Yonvay/Servomechanisms_projects/Academic Project/Trayectoria/analysisDH.jpg

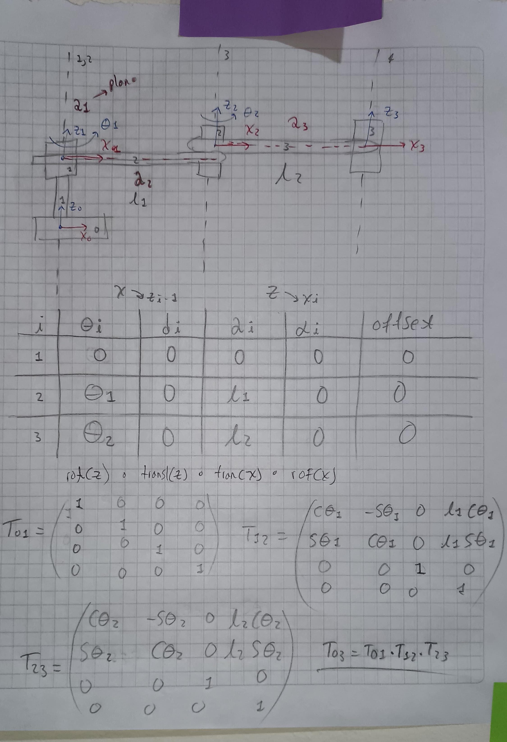
Academic Project/Trayectoria/analysisDH.jpg
