Yonvay/Servomechanisms_projects/README.md

# Servomechanisms_projects
Academic and industrial project, the first is a robotic arm capable of drawing a clover with more than 2 leaves. The second is a box assembler, with 3 servomotors.
