Yonvay/Servomechanisms_projects/Academic Project/Proyecto academico, R. David, M. Brian & V. Yovany.pdf

Informe Tecnico de Ingenier ´ | ía: Mecanismo 2R de Movimiento Controlado

Yovany Esneider Vargas Gutierrez Ingeniería Mecatronica ´
Universidad Nacional de Colombia Bogota, Colombia ´
yvargasgu@unal.edu.co

David Andres Ricaurte de Lima ´ Ingeniería Mecatronica ´
Universidad Nacional de Colombia Bogota, Colombia ´
dricaurte@unal.edu.co
Brian Enrique Munoz Garc ˜ | ía
Ingeniería Mecatronica ´
Universidad Nacional de Colombia Bogota, Colombia ´
bmunozg@unal.edu.co

Abstract—This academic project involves the design, implementation, and validation of a 2R mechanism with 2 degrees of freedom (DOF) that can automatically follow a predefined ”stylized clover” trajectory. The project emphasizes collaborative learning through Problem-Based Learning (PBL) and includes modeling, simulations, and physical experiments. The mechanism operates in a vertical plane with two motorized rotational joints, with trajectory tracking and real-time visualization.
Index Terms—2R Mechanism, Servomechanism, Problem-Based Learning (PBL), Degrees of Freedom (DOF), Controlled Trajectory, Collaborative Work, Mechatronics Engineering.
I. INTRODUCCION´
A. Descripcion del Problema ´
El problema que se busca resolver en este proyecto es el desarrollo y validacion de un mecanismo 2R con 2 grados de ´ libertad (DOF) capaz de seguir una trayectoria predefinida en un plano vertical. Este mecanismo es esencial en aplicaciones donde se requiere un control preciso del movimiento, como en robots o sistemas automatizados. La dificultad radica en garantizar que el mecanismo siga la trayectoria con precision, ´ manteniendo una velocidad constante y permitiendo ajustes de escala y rotacion, lo cual es fundamental para aplicaciones ´ industriales y de investigacion. ´
B. Objetivos
1) Objetivo General:
a) Concebir, disenar, implementar y validar un ˜ mecanismo 2R controlado que siga una trayectoria definida con precision. ´
2) Objetivos Específicos:
a) Realizar el modelado matematico y simulaciones ´ del mecanismo 2R.
b) Implementar físicamente el mecanismo y sus componentes motorizados.
c) Desarrollar un sistema de control que permita la automatizacion del seguimiento de la trayectoria. ´
d) Validar el funcionamiento del mecanismo mediante pruebas experimentales y comparacion con la ´ trayectoria deseada.
e) Promover el aprendizaje colaborativo y la gestion´ eficiente del proyecto en equipo.
C. Alcance del Proyecto
Este proyecto abarca desde la concepcion hasta la validaci ´ | on´
de un mecanismo 2R controlado, limitandose a operar en ´ un plano vertical con dos articulaciones rotacionales. Las consideraciones especiales incluyen el desarrollo de un sistema de control que permita el ajuste de la escala de la trayectoria hasta un factor de 1.33 y la rotacion de hasta 45 grados. Se ´ debe garantizar una velocidad constante en el seguimiento de la trayectoria, que varía entre 1 y 10 cm/s. Las limitaciones incluyen la precision del seguimiento de la trayectoria y la ´ cantidad de ciclos que el mecanismo puede realizar, con un
maximo de 10 ciclos en operaci ´ | on continua. ´
II. ANALISIS Y ´ | DISENO DE ˜ | INGENIERÍA
A. Conceptualizacion del Mecanismo 2R ´
El mecanismo 2R es un sistema mecanico compuesto por ´ dos eslabones moviles conectados mediante articulaciones ´ rotacionales, conocidas como juntas R (revolutas). Este tipo de mecanismo se caracteriza por su capacidad de moverse en un plano bidimensional, lo que lo convierte en un sistema con 2 grados de libertad (DOF). Cada grado de libertad corresponde
a la rotacion independiente de cada eslab ´ | | on en torno a su ´
respectiva articulacion. ´
En un mecanismo 2R, la posicion y orientaci ´ | on del extremo ´
distal del segundo eslabon (o efector final) dependen de los ´
angulos de rotaci ´ | on en las dos juntas. Esto se representa ´
matematicamente mediante un conjunto de ecuaciones que ´ describen la cinematica directa e inversa del sistema. La ´
cinematica directa calcula la posici ´ | on del efector final a partir ´
de los angulos de las juntas, mientras que la cinem ´ | atica inversa ´
determina los angulos necesarios para que el efector final ´ alcance una posicion deseada. ´
B. Modelado Matematico ´
1) Definicion del perfil de movimiento: ´ | | A continuacion se ´
muestran las graficas de perfil de movimiento para cuando ´

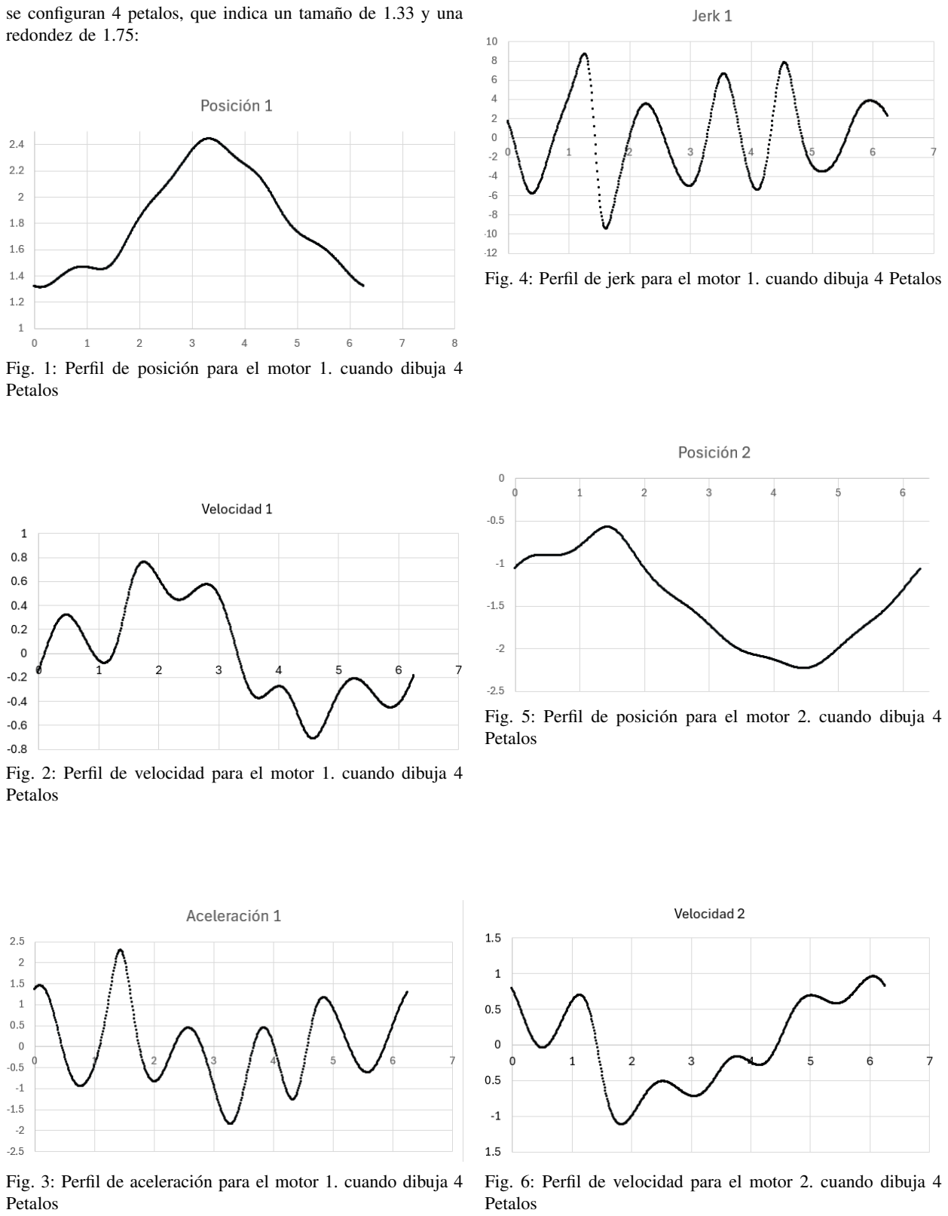
[picture p2: page 2]

se configuran 4 petalos, que indica un tamano de 1.33 y una ˜ redondez de 1.75:

Fig. 1: Perfil de posicion para el motor 1. cuando dibuja 4 ´ Petalos

Fig. 2: Perfil de velocidad para el motor 1. cuando dibuja 4 Petalos

Fig. 3: Perfil de aceleracion para el motor 1. cuando dibuja 4 ´ Petalos

Fig. 4: Perfil de jerk para el motor 1. cuando dibuja 4 Petalos

Fig. 5: Perfil de posicion para el motor 2. cuando dibuja 4 ´ Petalos

Fig. 6: Perfil de velocidad para el motor 2. cuando dibuja 4 Petalos

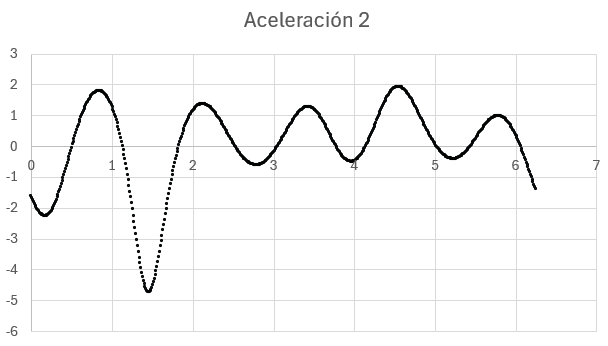
[picture p3: figure]

Fig. 7: Perfil de aceleracion para el motor 2. cuando dibuja 4 ´ Petalos

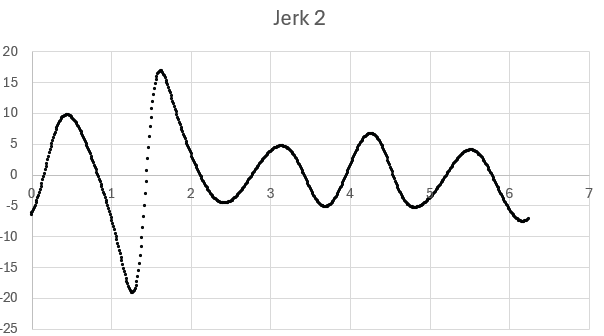
[picture p4: figure]

Fig. 8: Perfil de jerk para el motor 2. cuando dibuja 4 Petalos

2) Cinematica directa: ´ | A continuacion se presenta el dia- ´
grama en el que se asignan los marcos de referencia segun la ´ convencion DH: ´

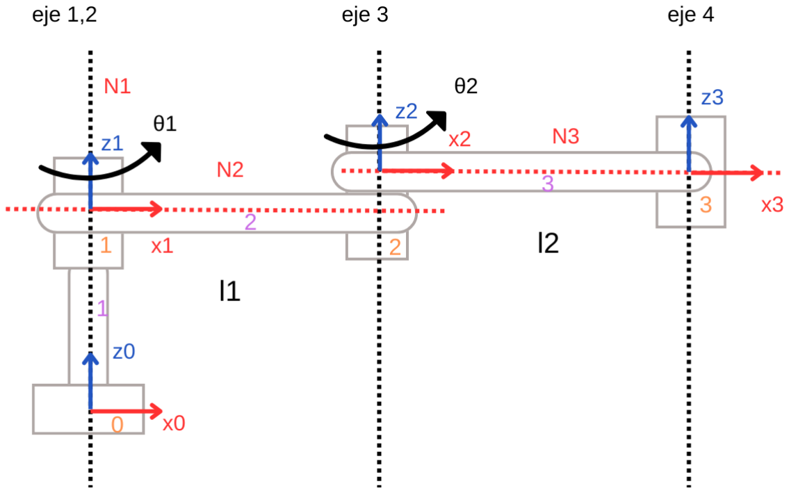
[picture p5: figure]

Fig. 9: Diagrama DH

A continuacion se presenta la tabla de par ´ | ametros DH: ´

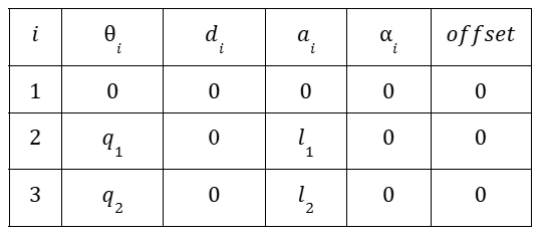
[picture p6: figure]

Fig. 10: Tabla de parametros DH ´

Las rotaciones y traslaciones que se realizan para llegar a la matriz del origen a la punta son:

rot(z) ∗ transl(z) ∗ transl(x) ∗ rot(x)

A continuacion se presentan las matrices ´ | T01, T12, T23

1 0 0 0
0 1 0 0
0 0 1 0
0 0 0 1

Fig. 11: Matriz T01

cos θ1 | − sin θ1 | 0 l1 · cos θ1
sin θ1 | cos θ1 | 0 l1 · sin θ1
0 | 0 | 1 | 0
0 | 0 | 0 | 1

Fig. 12: Matriz T12

cos θ2 | − sin θ2 | 0 l2 · cos θ2
sin θ2 | cos θ2 | 0 l2 · sin θ2
0 | 0 | 1 | 0
0 | 0 | 0 | 1

Fig. 13: Matriz T23

Ahora,para hallar las matriz para un punto a que se alcanza con θ1 y θ2:

T03 = T01 ∗ T12 ∗ T23

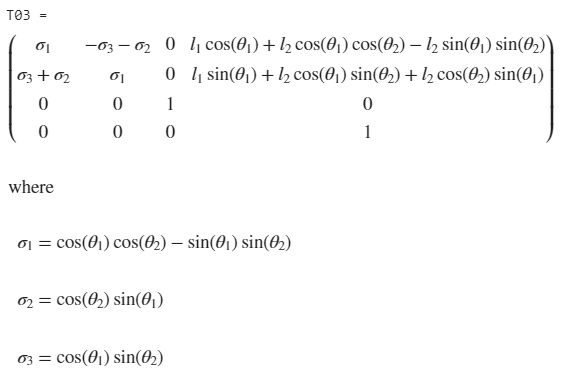
[picture p7: figure]

Fig. 14: Matriz T03

A continuacion se desarrolla la cinem ´ | atica inversa: ´

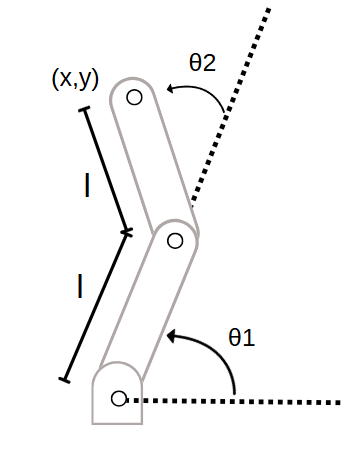
[picture p8: figure]

Fig. 15: Diagrama del mecanismo

Primero se definen los angulos: ´

θ1 =

β + γ
2

β = θ1 + θ3, β = 2atan2(y/x)

γ = θ1 − θ3, cos(

θ1 − θ3
2
) = | x 2l ∗ cos(β/2)

sen
θ1 − θ3
2
=

r
1 − cos²( | θ1 − θ3
| 2

)

γ = 2 · a tan 2

sen
θ1 − θ3
2

, cos
θ1 − θ3
2

θ2 = θ3 − θ1

θ2 = β − 2θ1

Estas ecuaciones surgen de la matriz T03, bajo la condicion´ de que l1 = l2, y haciendo uso de identidades trignometricas ´ como el producto de senos y cosenos. Ademas de las ecua- ´ ciones 1 y 2 que describen la trayectoria seguir.

x = S · Si · (cos (t · Le + R) + Ro) · cos(t) + Ox | (1)
y = S · Si · (cos (t · Le + R) + Ro) · sin(t) + Oy | (2)
S = Scale, | R = Rotation
Si = Size, | Ro = Roundness
Le = Leaf ts, | Ox, Oy = Offsets x & y
C. Seleccion de motores ´
Para la seleccion de motores, se tom ´ | o el caso donde el motor ´
ejerce el mayor torque, siendo este cuando los brazos estan a ´ nivel del suelo. Por ello, la sumatoria de torques constaría de dos componentes.

τm = I · α + τg

Motor 1

τm1 = 6, 60983e

−3Kg · m²
- 0, 95

rad
s

2

+ 0, 142m · 0, 142Kg · 9, 8

m
s

2
τm1 = 0, 2Nm
R.P.M1 = 4, 46r.p.m.

Se selecciono un motor DC, de 12 V. Con 0,6 Nm y 150 r.p.m. ´

Motor 2

τm1 = 1, 98231e

−3Kg · m²

- 1, 47rad
s

2

+ 0, 057m · 0, 018Kg · 9, 8

m
s

2
τm1 = 0, 01Nm
R.P.M1 = 6, 56r.p.m.

Se selecciono un motor DC, de 12 V. Con 0,14 Nm y 130 ´ r.p.m.

D. Caracterizacion de motores ´

Para la caracterizacion de motores se suministro el nivel ´ de PWM necesario para mover el mecanismo, en 5 ocasiones. Tomando como valor para Km y τm la media de las 5 medidas.

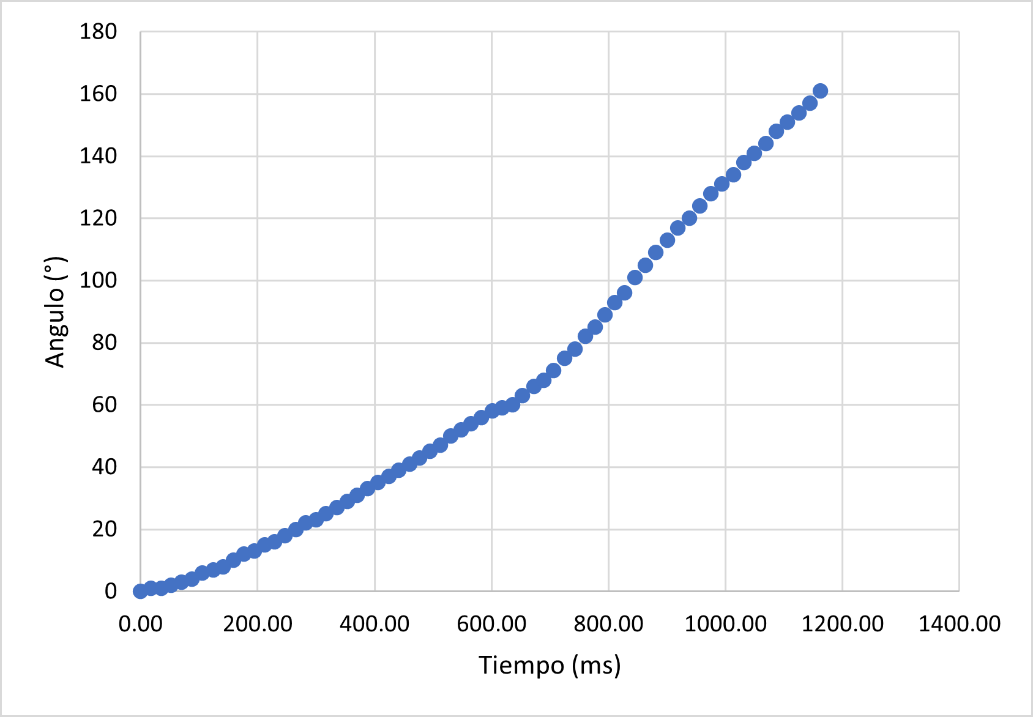
[picture p9: figure]

Fig. 16: Datos experimentales, motor 1.

Obteniendo un Km1 = 1, 9

v·rad
s

, y un τm1 = 300ms.

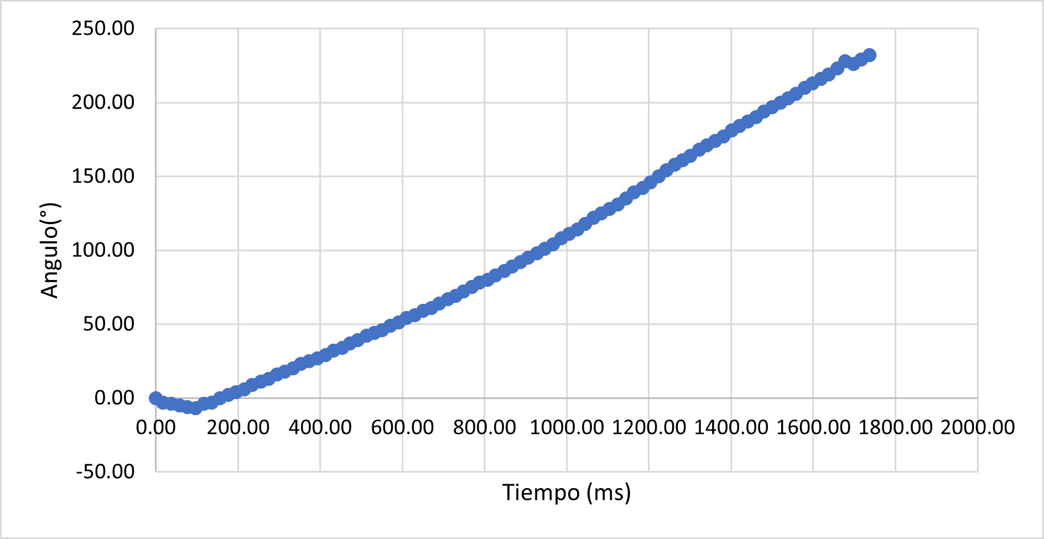
[picture p10: figure]

Fig. 17: Datos experimentales, motor 2.

Obteniendo un Km2 = 11 v·rad
s

, y un τm2 = 375ms.

E. Simulacion´

Simulaciones del sistema de control realizadas con simulink para el motor 1:

Nota: Las constantes P y D del controlador son 7 y 1,16 respectivamente.

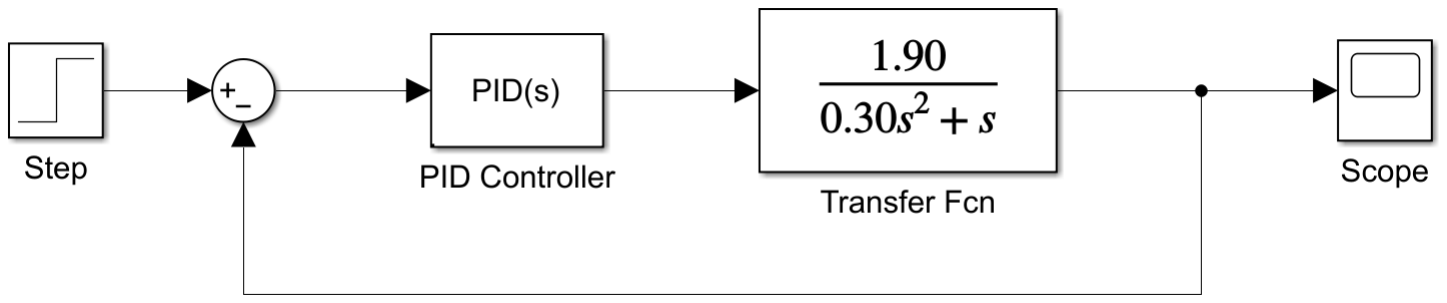
[picture p11: figure]

Fig. 18: Diagrama de bloques para el motor de la base

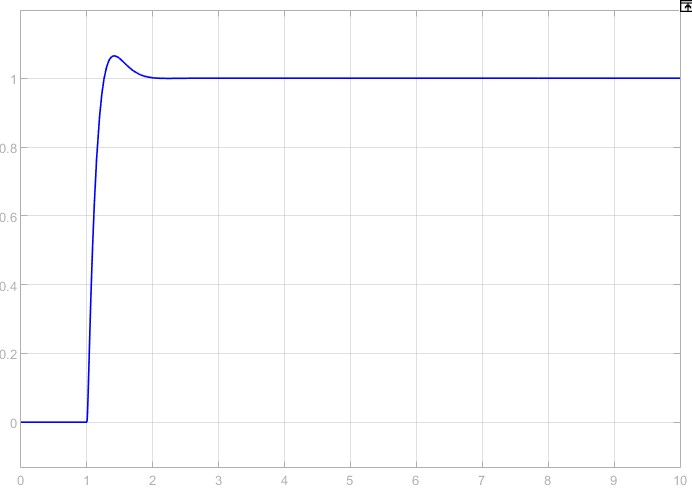
[picture p12: figure]

Fig. 19: Respuesta de control para el Motor de la base

Simulaciones del sistema de control realizadas con simulink para el motor 2: Nota: Las constantes P y D del controlador son 10 y 1,72 respectivamente.

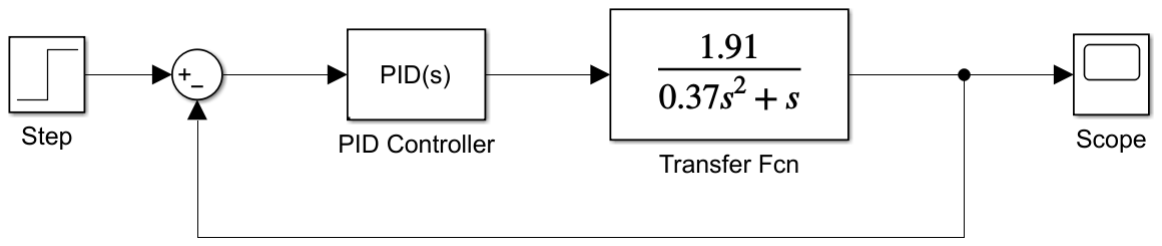
[picture p13: figure]

Fig. 20: Diagrama de bloques para el motor de la base

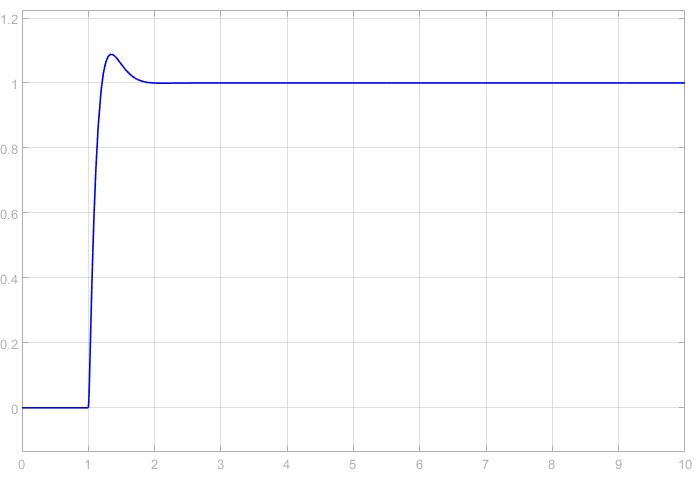
[picture p14: figure]

Fig. 21: Respuesta de control para el Motor de la base

F. Modelado CAD del sistema

Definidas las dimensiones de las articulaciones y sus rangos de movimiento, se diseno el mecanismo utilizando Autodesk ˜ Inventor para su modelado CAD.
Se disenaron las piezas para ser fabricadas en policarbonato, ˜ respetando las distancias entre ejes definidas anteriormente, y asegurando el correcto montaje de los motores y los encoders.

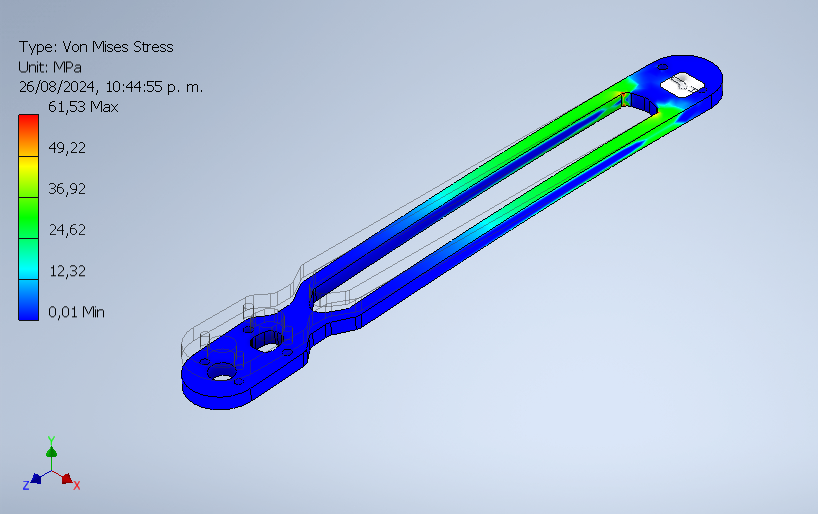
[picture p15: figure]

Fig. 22: Analisis de esfuerzo ´

Para la optimizacion del dise ´ | no de los brazos del mecan- ˜
ismo, se hizo un analisis de esfuerzos acompa ´ | nado de un ˜
diseno generativo para encontrar una geometr ˜ | ía que soportara
las cargas requeridas, pero que ahorrara en material y redujera el peso, esto para disminuir el momento de inercia de las piezas, y por ende la carga reflejada en los motores. Disenadas todas las piezas, se hizo el modelo del ensamble ˜ completo del mecanismo, de esta manera se pudo verificar
la compatibilidad mecanica de las piezas as ´ | í como obtener el
calculo de los momentos de inercia en los dos ejes de rotacion. ´

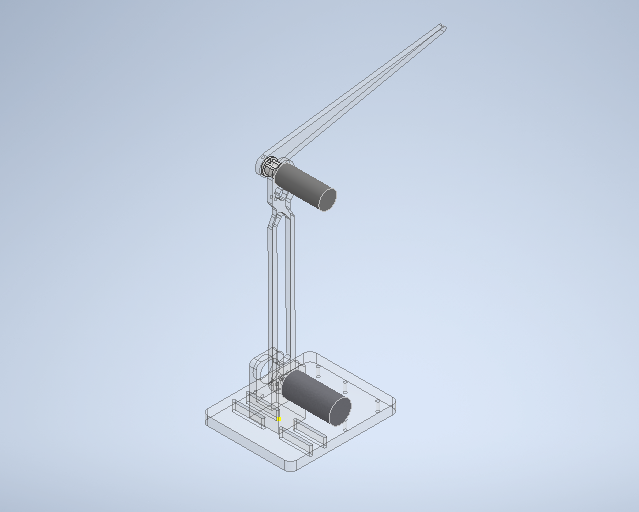
[picture p16: figure]

Fig. 23: Ensamble del mecanismo

G. Diseno del Sistema de Control ˜
Descripcion del sistema de control propuesto, incluyendo ´ los algoritmos de control, diagrama de bloques y su implementacion. ´
La expresion que describe la funci ´ | on de transferencia del ´
controlador PID es:

P ID =

Kps + Ki + Kss

2
| s
Por otra parte la funcion de transferencia de la planta es: ´
G(s) = | Km′
| s(τms + 1)
Realizando la operacion de bloques para hallar la funci ´ | on´
de transferencia del sistema sin retroalimentacion queda: ´

G1(s) = Km′ (Kds

2 + Kps + ki)
s

2(τms + 1)

Realizando la operacion de bloques para hallar la funci ´ | on´
de transferencia del sistema con retroalimentacion queda: ´
T(s) = | Km′ (Kds

2 + Kps + ki)
Km′ (Kds

2 + Kps + ki) + s
2(τms + 1)

Expandiendo el denominador:

T(s) = | Km′ (Kds

2 + Kps + ki)
Km′Kds

2 + Km′Kps + Km′ki + s

3τm + s

2

T(s) = | Km′ (Kds

2 + Kps + Ki)
s

3τm + s

| 2(Km′Kd + 1) + s(Km′Kp) + Km′Ki

Reorganizando y tomando Ki = 0, debido a que el controlador no tendra integrador, queda: ´

T(s) =

Km′
τm

(Kds + Kp)

s

2 + s

Km′Kd+1
τm
+

Km′Kp
τm

2ζWn =

Km′Kd + 1
τm

ζ =

1
2

p
Km′ τmKp

(Km′Kd + 1)

ζ ≈ 0.8

Kp1 = 8

Kd1 = 1.28

Kp2 = 11

Kd2 = 1.83

Donde Kp | > Kd, permitiendo modificar el factor de
amortiguacion del sistema ´ | ζ.

III. IMPLEMENTACION´

A. Descripcion de Componentes ´
- Encoders Magnetico AS5600: Estos encoders son sen- ´ sores de posicion rotativos que utilizan un campo ´
magnetico para determinar la posici ´ | on angular. Ofrecen ´
una resolucion de 12 bits, lo que permite una precisi ´ | on de ´
0.087 grados. Son ideales para aplicaciones que requieren mediciones precisas de angulos. ´

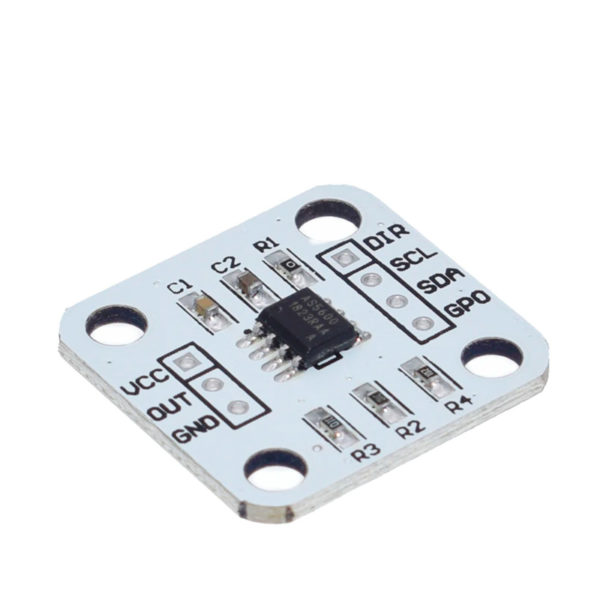
[picture p17: figure]

Fig. 24: Encoder Magnetico AS5600 ´

- Motor de la base: Motorreductor 6 Kg*cm - 130 RPM (12V) 25GA, con engranajes metalicos ´

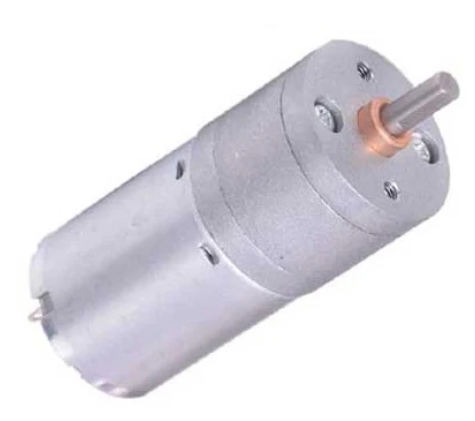
[picture p18: figure]

Fig. 25: Motor de la base

- Motor del segundo brazo: Referencia JF310. Motorreductor Dc 1.5 Kgr cm 12v 150 Rpm Eje Centrado

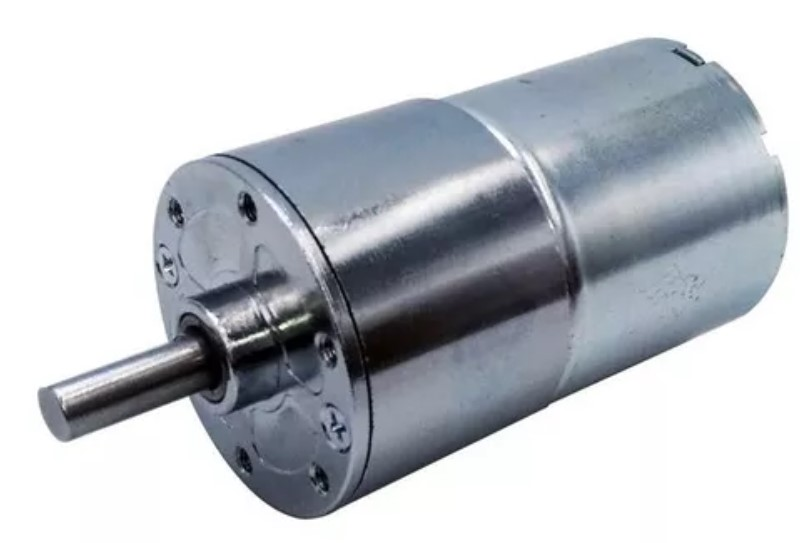
[picture p19: figure]

Fig. 26: Motor del segundo brazo

- Arduino UNO: Es una placa de desarrollo basada en el microcontrolador ATmega328P. Es muy popular en
proyectos de electronica y rob ´ | otica debido a su facilidad ´
de uso y amplia comunidad de soporte. Cuenta con 14 pines digitales de entrada/salida, 6 entradas analogicas y ´
una conexion USB para programaci ´ | on y comunicaci ´ | on´

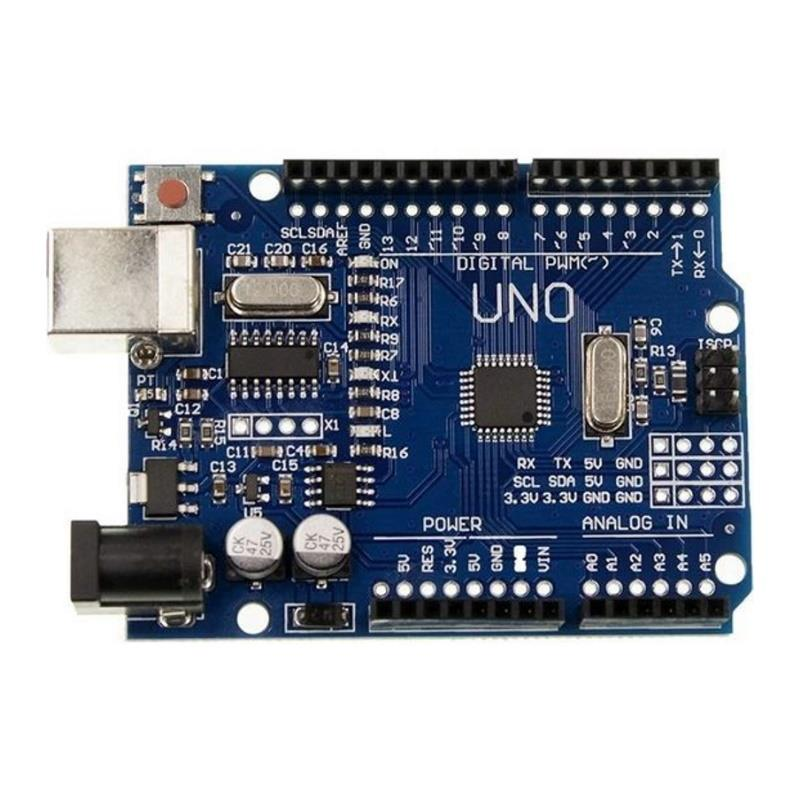
[picture p20: figure]

Fig. 27: Arduino UNO R3

- Puente H L298N: es un motor driver con un doble puente H que nos permite manejar dos motores de corriente continua o un motor paso a paso bipolar de entre 5V y 35V y de hasta 2 amperios, controlando la velocidad y el sentido de giro de nuestros motores.

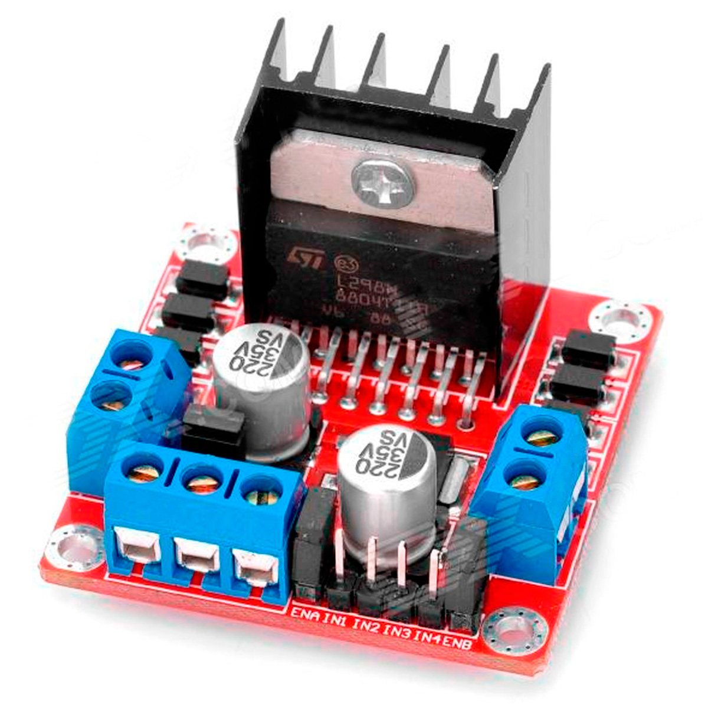
[picture p21: figure]

Fig. 28: Puente H L298N

- Brazos cortados en acrílico: Los brazos de acrílico se utilizan como elementos estructurales en el mecanismo. El acrílico es un material ligero, resistente y facil de cortar ´ con laser, lo que permite crear piezas personalizadas con ´ precision. ´

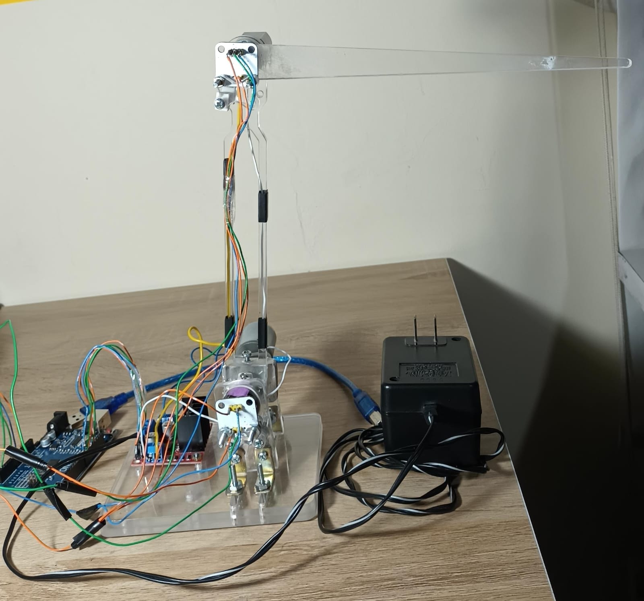
[picture p22: figure]

Fig. 29: Brazos cortados en acrílico

- Acoples impresos en 3D: Los acoples son piezas que conectan diferentes partes del mecanismo. La impresion´ 3D permite fabricar acoples personalizados y complejos que se ajustan perfectamente a las necesidades del proyecto.

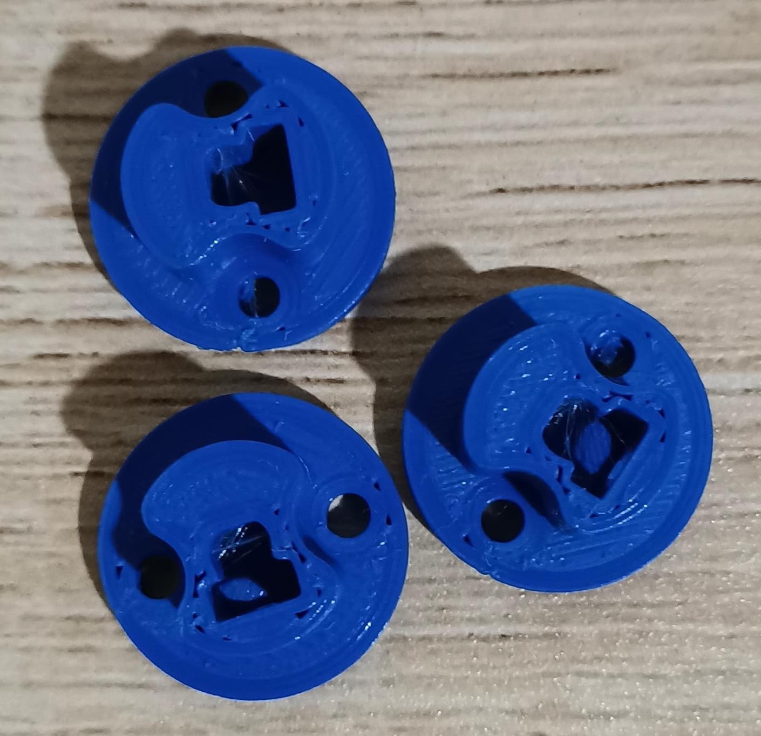
[picture p23: figure]

Fig. 30: Acoples impresos en 3D

- Tornillos M3: Son tornillos de metrica 3 mm, ´
comunmente utilizados en proyectos de electr ´ | onica y ´
robotica para ensamblar componentes. Son peque ´ | nos, ˜
pero proporcionan una sujecion segura y estable. ´
- Cable de protoboard: Son flexibles y faciles de usar, ´ permitiendo conectar componentes electronicos usando ´ soldadura.
- Rodamiento de 8mm: : Los rodamientos se utilizan para
reducir la friccion entre partes m ´ | oviles del mecanismo. ´
Un rodamiento de 8 mm es adecuado para ejes de ese diametro, permitiendo un movimiento suave y preciso. ´
B. Integracion del Sistema de Control ´
El sistema de control se integro mediante un microchip programable de alta frecuencia (Arduino), allí se implemento toda la programacion necesaria. ´
Partiendo por una funcion la cual retorna los ´ | angulos ´
de referencia por paso de trayectoria.

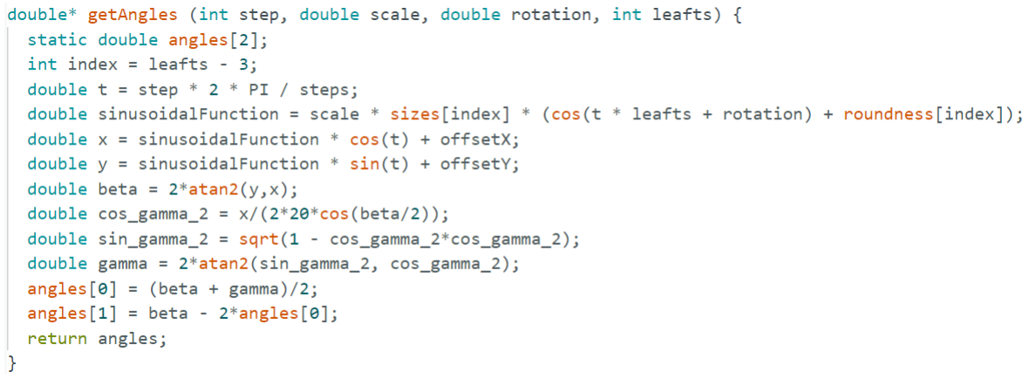
[picture p24: figure]

Fig. 31: Funcion getAngles, para obtener ´ | θ1 y θ2.

Seguidamente se implemento el control PD, con la nomen-
clatura clasica, realizando primero la operaci ´ | on pertinente, ´
para adicionar la ganancia en de cada factor.

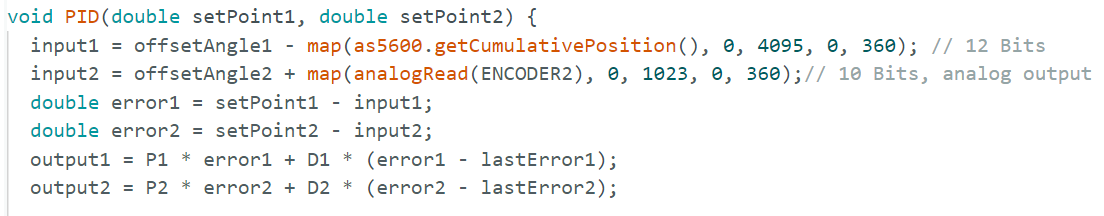
[picture p25: figure]

Fig. 32: Funcion de control PID. ´

Adicionalmente para evitar la perdida de control, con errores muy grandes, se implemento una funcion de control PID ´ suavizado, de manera que si el error es muy grande, el punto de operacion sea reasignado. ´

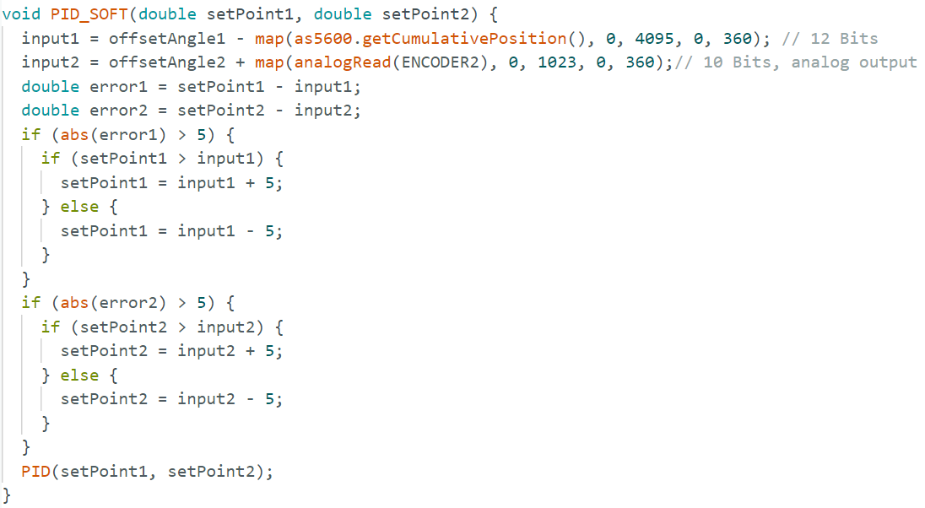
[picture p26: figure]

Fig. 33: Funcion de control PID suavizado. ´

Para el manejo del mecanismo, se hizo uso de funciones
de interfaz, ademas del uso de Matlab para la activaci ´ | on y ´
modificacion de la trayectoria. ´

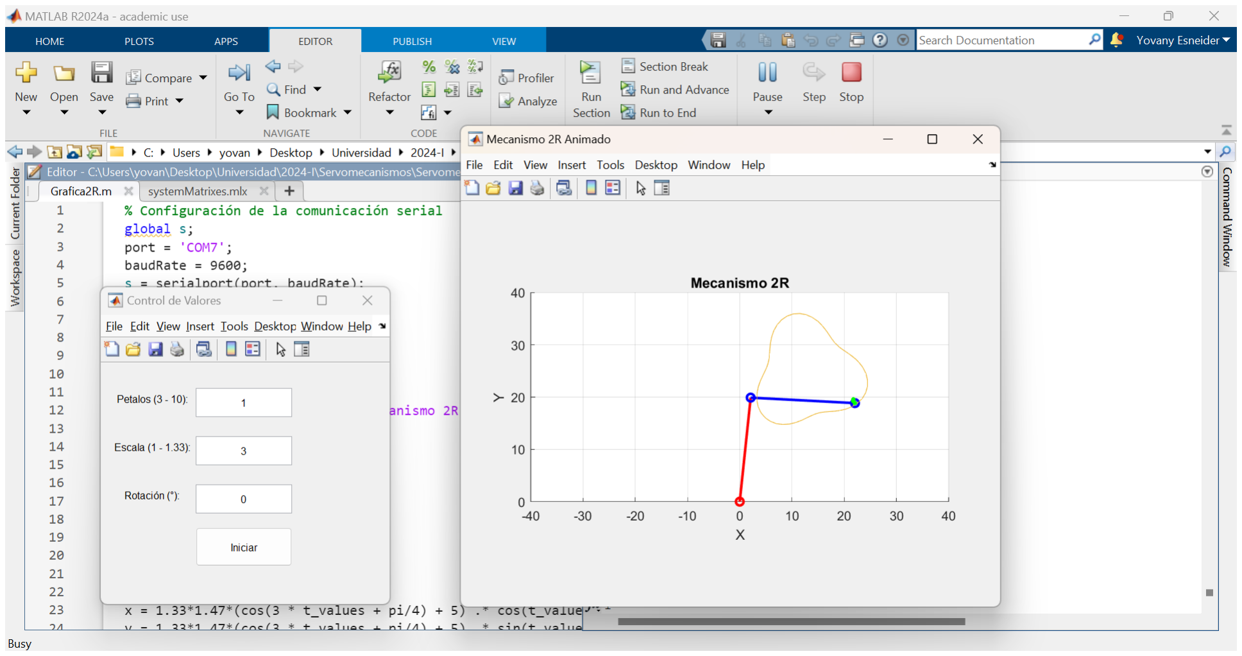
[picture p27: figure]

Fig. 34: HMI en Matlab.

El script en MATLAB se utiliza para graficar y animar
el mecanismo en funcion de los ´ | angulos proporcionados ´
por el Arduino a traves de comunicaci ´ | on serial. El mecan- ´
ismo se dibuja en una ventana principal que muestra los eslabones y acumula los puntos extremos de su movimiento. Simultaneamente, se abre una ventana secundaria de control ´ con cajas de texto para ingresar valores personalizados para la
parametrizacion de la trayectoria (Escala, Rotaci ´ | on y n ´ | umero ´
de petalos) y un bot ´ | on para enviar estos valores al Arduino en ´
formato JSON. El script se mantiene en ejecucion continua, ´ actualizando la grafica cada vez que recibe nuevos datos del ´ Arduino, hasta que se cierre manualmente.
Para una mejor comprension de todo el procedimiento ´ llevado a cabo, puede visitar el repositorio, donde se encuentra
toda la documentacion completa. ´ | Repositoria GitHub. (https://github.com/Yonvay/Servomechanisms_projects)

IV. FUNCIONAMIENTO

A. Pruebas de Validacion´

Para la validacion se hizo uso del software Matlab, donde se ´ compara en tiempo real la trayectoria teorica y la trayectoria ´ real del mecanismo. Se llevaron a cabo 3 pruebas.
- Prueba de la trayectoria a escala 1.0 y rotacion 0°. ´
- Prueba de la trayectoria a escala 1.33 y rotacion 0°. ´
- Prueba de la trayectoria a escala 1.33 y rotacion 45°. ´ Vídeos de demostracion´ (https://drive.google.com/drive/folders/1a5nXQAplEdyd9wi0S7CDouiw_1W24cd_?usp=drive_link) .
B. Resultados Obtenidos

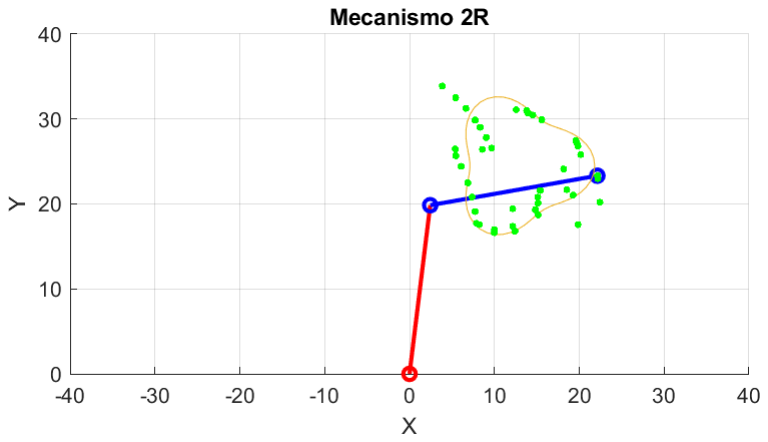
[picture p28: figure]

Fig. 35: Trayectoria a escala 1 y rotacion 0. ´

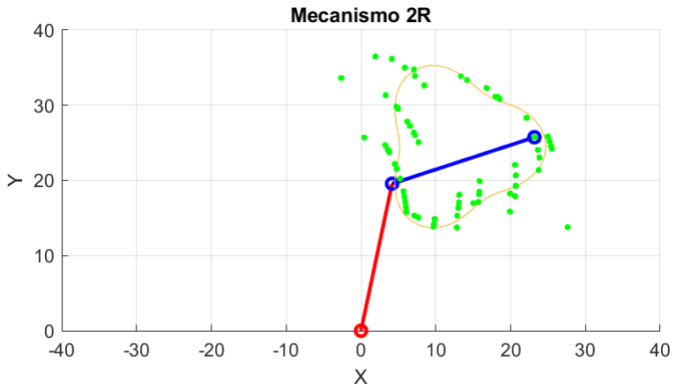
[picture p29: figure]

Fig. 36: Trayectoria a escala 1.33 y rotacion 0. ´

La precision se vio afectada debido a las condiciones del ´ mecanismo, donde al estar ensamblado por partes individuales, un movimiento brusco del control podría desestabilizar, ademas de que el motor de la base cuenta con un juego ´ incorregible de 7°, lo que escala a error en la precision de ´ hasta 15°.
A partir de los datos recolectados, la velocidad se halla con la distancia recorrida sobre el tiempo empleado. Siendo la velocidad teorica de 2.71 cm/s y la experimental de 3.87 ´ cm/s, debido a las correcciones bruscas del error por parte del controlador.
C. Discusion de Resultados ´
Teniendo en cuenta todas las variables y dificultades del mecanismo, los resultados fueron los esperados. Donde las trayectorias obtenidas se aproximan a las reales, y los
parametros como la escala y la rotaci ´ | on tienen un compor- ´
tamiento ideal.
V. REFLEXIONES SOBRE EL PROCESO
A. Gestion de Proyecto ´
El manejo del tiempo fue aceptable, aunque se presentaron retrasos por inconvenientes de la naturaleza del mecanismo, se logro cumplir a tiempo con la entrega. ´
Respecto a los recursos, se reutilizaron materiales como el acrílico y el primer motor, todo lo demas fue adquirido, donde ´ cada integrante aporto una parte igualitaria en dinero. Respecto a las reuniones de grupo, solo se hicieron 2 re-
uniones, para discutir el metodo de ejecuci ´ | on, seguidamente ´
solo hubo comunicacion mediante electr ´ | onica y personal. ´
B. Trabajo Colaborativo
Hubo buena sincronizacion por parte del grupo, donde las ´
tareas se repartieron en 3 principales ejes, diseno, simulaci ˜ | on´
y ensamble.
La parte de diseno, fue llevada a cabo en conjunto, aqu ˜ | í
entraron todos los calculos necesarios, cinem ´ | aticas, c ´ | alculos de ´
control, longitudes y ganancias. Ademas de debatir el material ´ a utilizar y la manera de acoplar los motores al mecanismo.
Para la parte de simulacion, se encargo Brian Mu ´ | noz y David ˜
Ricaurte, donde se utilizo el software de Matlab, se llevo a
cabo la simulacion de los sistemas y una peque ´ | na interfaz ˜
de control para el mecanismo. La cual permite comparar los valores teoricos con los reales en tiempo real. ´
Para la parte de ensamble, se encargo Yovany Vargas, allí hubieron multiples dificultades, ya que los acoples al ser de ´ plastico presentan una fragilidad alta, teniendo que ensamblar ´ el mecanismo en multiples ocasiones, y siendo esta la principal ´ causa de los retrasos en los resultados.
Analisis grupal de la colaboraci ´ | on dentro del equipo, roles y ´
responsabilidades, y la interaccion con el docente facilitador. ´ Para el trabajo en sincronico se utilizo GitHub como interme- ´ diario entre los integrantes.
C. Proceso de Aprendizaje
1) David Andres: ´ En el desarrollo del proyecto, el enfoque de aprendizaje basado en problemas me permitio relacionar ´
directamente los conceptos teoricos con la pr ´ | actica. ´
A traves de la construcci ´ | on del prototipo, reforc ´ | e competencias ´
tecnicas, como el manejo de herramientas de modelado CAD y ´
de software de simulacion como MATLAB, Simult ´ | aneamente, ´
aprendía a trabajar de manera colaborativa, gestionando las tareas, el tiempo y los recursos de manera efectiva. Considero que este enfoque fomento mi capacidad de au- ´ toaprendizaje y adaptacion frente a problemas inesperados, ´ como la necesidad de ajustar el diseno del mecanismo debido ˜ a incompatibilidades con otras partes del sistema.
Pero tambien creo que el proyecto podr ´ | | ía mejorar con una
planificacion m ´ | as detallada de las actividades, roles y recursos ´
disponibles.
2) Brian: Hay correspondencia con las actividades del curso en cuanto al desarrollo teorico y proceso para hallar ´ la funcion de transferencia. ´
Se determina que el encoder funciona de manera mas´ efectiva cuando su posicion es de parte del motor y no de ´ la estructura o mecanismo. Se recomienda compra el motor con encoder y con caja reductora integrados.
Los motores seleccionados no deben tener mucho torque debido a que el mínimo en funcionamiento del PWM necesario es muy alto para que el motor mueva el mecanismo. Y esto hace que se dificulte el controlar diferencias pequenas de ˜ angulos. ´
D. Recomendaciones para Futuros Proyectos
1) David Andres: ´ Mi principal recomendacion es a la hora ´ de disenar el sistema tratar de considerar todas las subsistemas ˜ que componen su funcionamiento, así a la hora de concebir el diseno de alguno de estos subsistemas, por ejemplo la ˜ parte electronica del sistema, de forma que no afecte el ´ funcionamiento de los otros subsistemas, influyendo en un mal funcionamiento del sistema completo. Siguiendo este enfoque es necesario, sobretodo si se divide el desarrollo de estos subsistemas, que entre los miembros del equipo haya una comunicacion clara de lso requerimientos y limitaciones de ´ funcionamiento que tiene cada uno.
2) Brian: Implementar un cronograma detallado con revi-
siones periodicas: Para mejorar la planificaci ´ | on del tiempo, se ´
sugiere establecer un cronograma específico con hitos claros para cada fase del proyecto. Este cronograma debe incluir momentos de revision intermedia para evaluar el avance y realizar ´ ajustes cuando sea necesario. Ademas, se recomienda el uso de ´ herramientas de gestion de proyectos que permitan visualizar ´ el progreso y detectar posibles retrasos con anticipacion. De ´ esta manera, se optimiza la gestion de los recursos y se asegura ´ el cumplimiento de los plazos establecidos.
Documentar detalladamente cada paso del proceso: Es esencial llevar un registro exhaustivo de cada fase del proyecto, documentando tanto los exitos como los problemas y las soluciones ´
implementadas. Este registro permitira retroceder f ´ | acilmente ´
en caso de ser necesario, facilitando ajustes sin perder el
contexto del trabajo ya realizado. Ademas, la documentaci ´ | on´
detallada fomenta el aprendizaje continuo y mejora la transferencia de conocimiento dentro del equipo.
E. Yovany
No utilizar acoples de plastico, acr ´ | ílico o cualquier derivado
de plastico. Estos materiales no tienen la suficiente resistencia ´ para los torques que tienen los motores, rompiendose ante ´ cualquier envaneciendote. ´
No utilizar sensores AS5600, aunque su manipulacion es ´ sencilla, mantener los sensores alineados y sincronizados es una tarea sin fin, aunque cueste mas es mejor optar por ´ motoreductores con encoder incorporado. Ya que estos son precisos y no necesitan de sincronizacion previa. ´
No realizar el ensamble por piezas no enterizas, si se precisa
de algun soporte, este debe ser r ´ | ígido en conjunto con las
piezas.
Procurar una resolucion en los encoder de 12 bits, con esta se ´ puede tener una medida de hasta 2 revoluciones sin presentar ningun inconveniente, permitiendo una mayor libertad en el ´ mecanismo.

VI. CONCLUSIONES
- Con el analisis de control, se encontr ´ | o que el control PD ´
es el ideal para este tipo de sistemas, donde el factor derivativo influye directamente en la amortiguacion de la ´ respuesta.
- Si bien el analisis lagrangiano es correcto para la ´
cinematica en este tipo de mecanismo, el an ´ | alisis Denavit- ´
Hartenberg presenta una ventaja frente a este, siendo capaz de parametrizar.
- Aunque la intuicion dicte que a mayor torque y velocidad ´
pueda otorgar un motor, sera m´ | as f ´ | acil controlar una ´
inercia alta. Sin embargo, no es correcta esta afirmaci ´ | on, ´
se debe partir de los calculos de torque y velocidad para ´ la seleccion adecuada de los motores. ´
Síntesis de los hciallazgos y logros del proyecto, y sugerencias para trabajos futuros.

REFERENCIAS

[1] G. Victor, Notas de clase. Servomecanismos Universidad Nacional de Colombia. 2024.
[2] MathWorks, Documentation Center. MathWorks. Disponible en: https://la.mathworks.com/help/index.html. 2024.
