Yonvay/Servomechanisms_projects/(list of files, cad)

Other CAD files:
Academic Project/Diseño piezas/Acople3.ipt
Academic Project/Diseño piezas/EnsamblajeEslabones.iam
Academic Project/Diseño piezas/Ensamble.iam
Academic Project/Diseño piezas/Eslabon 1 - 2D.ipt
Academic Project/Diseño piezas/Eslabon 1.ipt
Academic Project/Diseño piezas/Eslabon 2 - 2D.ipt
Academic Project/Diseño piezas/Eslabon 2.ipt
Academic Project/Diseño piezas/Part2.ipt
Academic Project/Diseño piezas/Part51.ipt
Academic Project/Diseño piezas/acople.ipt
Academic Project/Diseño piezas/acople2.ipt
Academic Project/Diseño piezas/bas.ipt
Academic Project/Diseño piezas/base.ipt
Academic Project/Diseño piezas/puntero.ipt
