Yonvay/Servomechanisms_projects/(commit log)

2024-07-20 Análisis de posición
    Mediante análisis Denavit-Hartenberg se encontraron las matrices que describen la posición de los sistemas de referencia, siendo el tercero el más relevante.
2024-07-28 Cinemática completa
    Posición, velocidad, aceleración y jerk
    [Cálculos.xlsx]
2024-07-29 Diseño piezas
    Eslabon 1, Eslabon 2 y ensamble de eslabones
    [EnsamblajeEslabones.iam, Eslabon 1.ipt, Eslabon 2.ipt]
2024-07-29 Creación Carpeta
    carpeta
    [EnsamblajeEslabones.iam, Eslabon 1.ipt, Eslabon 2.ipt]
2024-08-03 Para sacar a formato DXF
    [Eslabon 1 - 2D.ipt, Eslabon 2 - 2D.ipt]
2024-08-27 Caracterización
    [10ms0.xlsm, 5.2ms0.xlsm, 5.2ms1.xlsm, 5ms0.xlsm, 5ms1.xlsm, Cálculos.xlsx, ParametrosMotores.xlsx]
2024-08-30 Control final
    [Cálculos.xlsx, ParametrosMotores.xlsx]
2024-09-02 Circuito de control
    [Cálculos.xlsx]
2024-09-04 Arduino graficador
2024-09-04 Script Matlab que grafica
2024-09-05 Modelos final
    [Acople3.ipt, Ensamble.iam, Part2.ipt, Part51.ipt, acople.ipt, acople2.ipt, bas.ipt, base.ipt]
2024-09-05 Control code & matlab
    [Cálculos.xlsx, ParametrosMotores.xlsx]
2024-09-07 Commit Final
    [ParametrosMotores.xlsx]
2024-10-02 Proyecto Industrial
    [5.2ms0.xlsm, 5.2ms1.xlsm, 5ms0.xlsm, 5ms1.xlsm, Acople3.ipt, Cálculos PI.xlsx, Cálculos.xlsx, EnsamblajeEslabones.iam]
2024-10-03 Cálculos finales
    [Cálculos PI.xlsx]
